dlobato/nixie12b_clock/README.md

# nixie12b_clock

This is just a simple project to build a clock using nixie displays. It's kind of a prototype to play with the nixies, although it's fully functional.
