dlobato/nixie12b_clock/hardware/nixie12b_clock.brd

## EAGLE design hardware/nixie12b_clock.brd (2015-03-19)

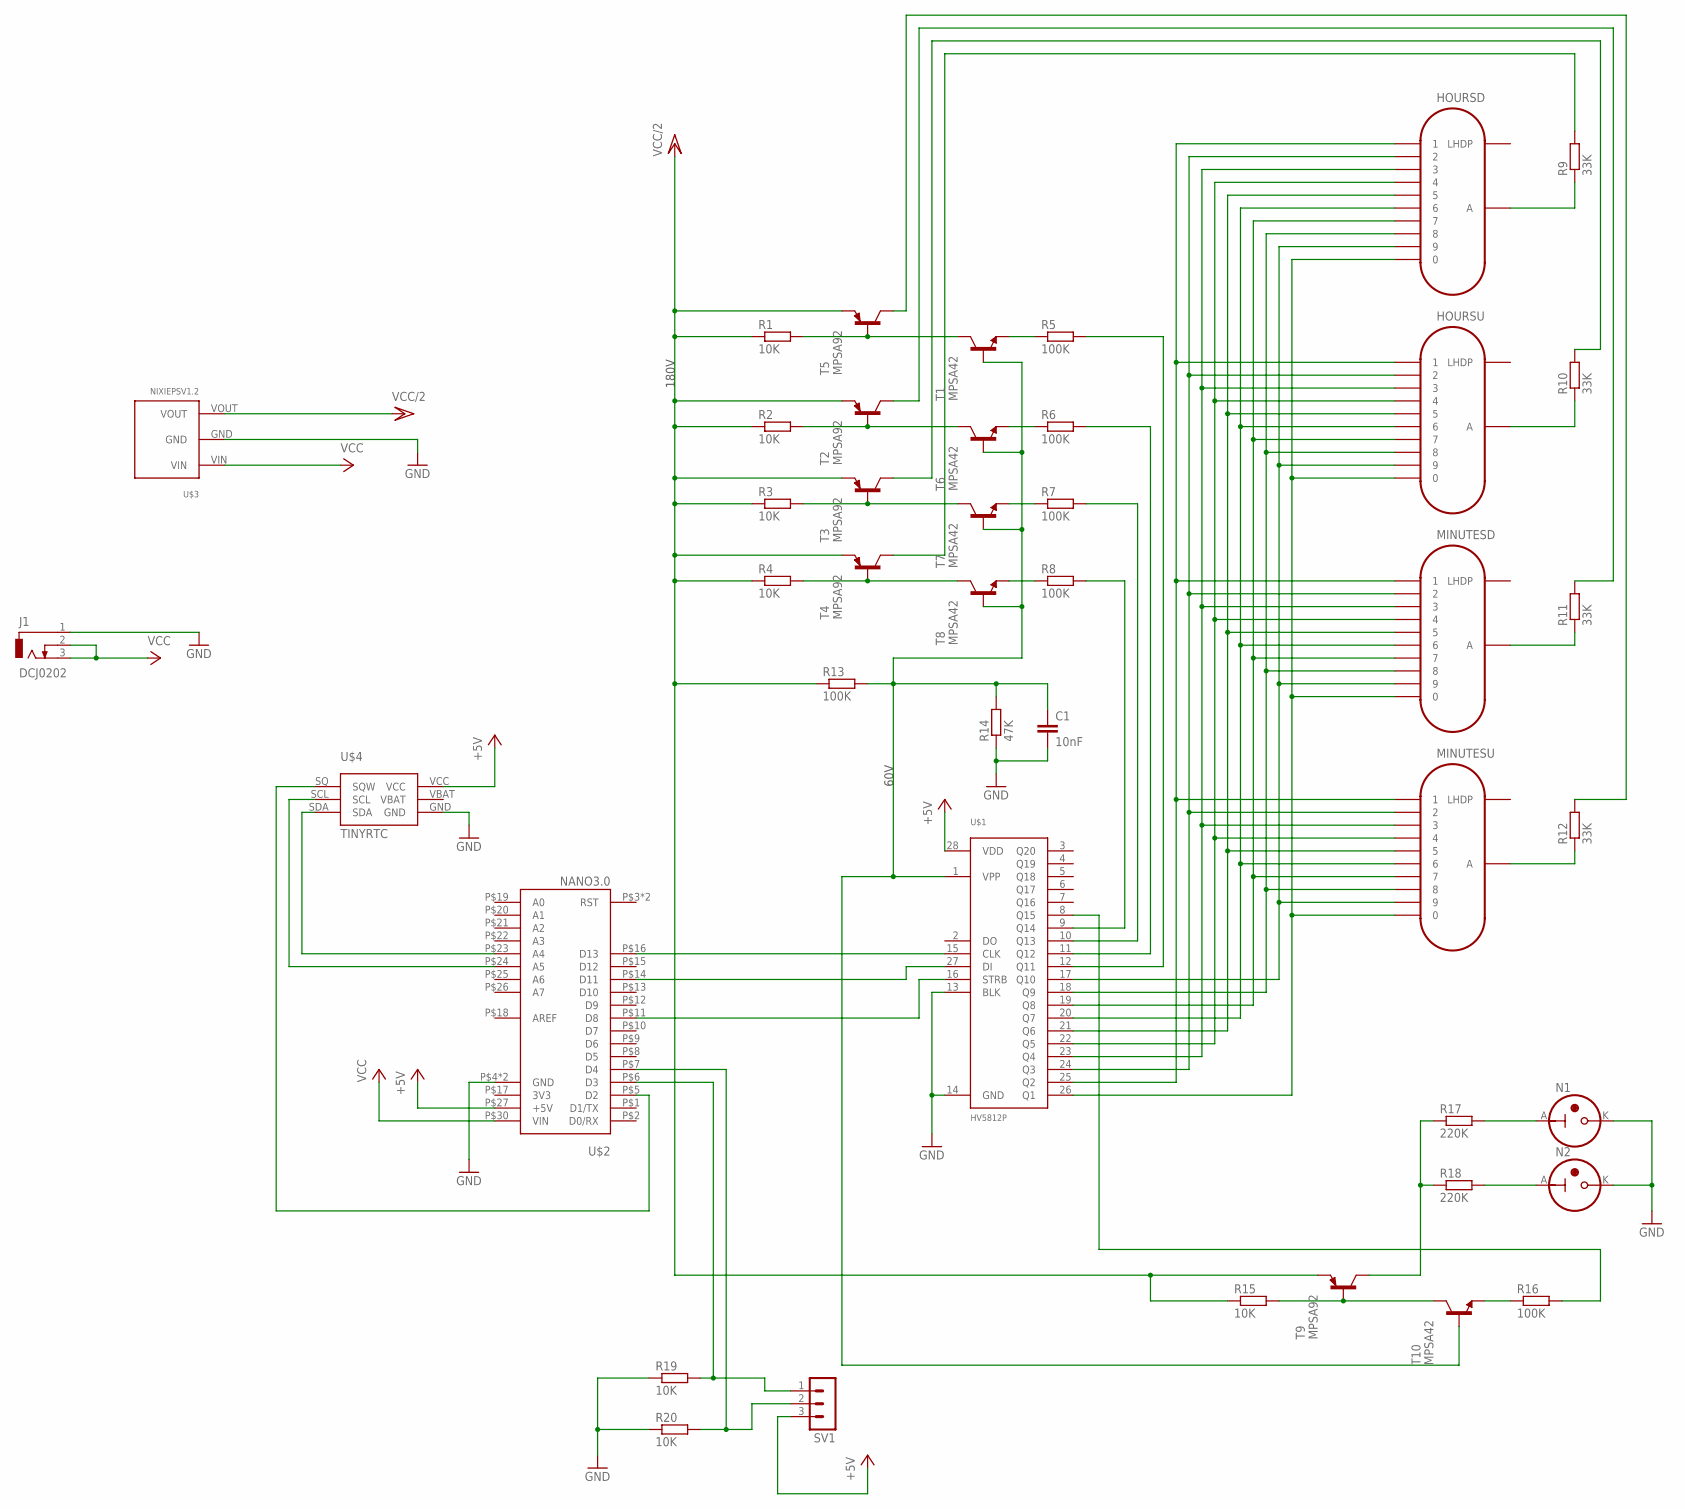
[picture p1: schematic nixie12b_clock.sch]

Parts:
C1: 10nF; C5B2.5
HOURSD: IN-12BP; IN-12-2
HOURSU: IN-12BP; IN-12-2
J1: DCJ0202
MINUTESD: IN-12BP; IN-12-2
MINUTESU: IN-12BP; IN-12-2
N1, N2: IN-3
R1, R2, R3, R4, R15, R19, R20: 10K; 0207/10
R5, R6, R7, R8, R13, R16: 100K; 0207/10
R9, R10, R11, R12: 33K; 0207/10
R14: 47K; 0207/10
R17, R18: 220K; 0207/10
SV1: MA03-1
T1, T6, T7, T8, T10: MPSA42; TO92-EBC
T2, T3, T4, T5, T9: MPSA92; TO92-EBC
U$1: HV5812P; 28-PDIP
U$2: NANO3.0; NANO3.0_HEADERS
U$3: NIXIEPSV1.2
U$4: TINYRTC

Connections:
3V3: U$2.P$17 (3V3)
+5V: SV1.3, U$1.28 (VDD), U$2.P$27 (+5V), U$4.VCC
GND: C1.2, J1.1, N1.K, N2.K, R14.1, R19.1, R20.1, U$1.13 (BLK), U$1.14 (GND), U$2.P$4 (GND), U$2.P$29 (GND), U$3.GND, U$4.GND
unnamed: HOURSD.1, HOURSU.1, MINUTESD.1, MINUTESU.1, U$1.25 (Q2)
unnamed: HOURSD.2, HOURSU.2, MINUTESD.2, MINUTESU.2, U$1.24 (Q3)
unnamed: HOURSD.3, HOURSU.3, MINUTESD.3, MINUTESU.3, U$1.23 (Q4)
unnamed: HOURSD.4, HOURSU.4, MINUTESD.4, MINUTESU.4, U$1.22 (Q5)
unnamed: HOURSD.5, HOURSU.5, MINUTESD.5, MINUTESU.5, U$1.21 (Q6)
unnamed: HOURSD.6, HOURSU.6, MINUTESD.6, MINUTESU.6, U$1.20 (Q7)
unnamed: HOURSD.7, HOURSU.7, MINUTESD.7, MINUTESU.7, U$1.19 (Q8)
unnamed: HOURSD.8, HOURSU.8, MINUTESD.8, MINUTESU.8, U$1.18 (Q9)
unnamed: HOURSD.9, HOURSU.9, MINUTESD.9, MINUTESU.9, U$1.17 (Q10)
unnamed: HOURSD.0, HOURSU.0, MINUTESD.0, MINUTESU.0, U$1.26 (Q1)
unnamed: R1.2, T1.C, T5.B
unnamed: R2.2, T2.B, T6.C
unnamed: R3.2, T3.B, T7.C
unnamed: R4.2, T4.B, T8.C
unnamed: R5.1, T1.E
unnamed: R6.1, T6.E
unnamed: R7.1, T7.E
unnamed: R8.1, T8.E
unnamed: C1.1, R13.2, R14.2, T1.B, T6.B, T7.B, T8.B, T10.B, U$1.1 (VPP)
unnamed: R5.2, U$1.12 (Q11)
unnamed: R6.2, U$1.11 (Q12)
unnamed: R7.2, U$1.10 (Q13)
unnamed: R8.2, U$1.9 (Q14)
unnamed: R9.2, T4.C
unnamed: HOURSD.A, R9.1
unnamed: R10.2, T3.C
unnamed: HOURSU.A, R10.1
unnamed: R11.2, T2.C
unnamed: MINUTESD.A, R11.1
unnamed: R12.2, T5.C
unnamed: MINUTESU.A, R12.1
unnamed: R15.2, T9.B, T10.C
unnamed: U$1.16 (STRB), U$2.P$11 (D8)
unnamed: U$1.27 (DI), U$2.P$14 (D11)
unnamed: U$1.15 (CLK), U$2.P$16 (D13)
unnamed: R19.2, SV1.1, U$2.P$6 (D3)
unnamed: R16.2, U$1.8 (Q15)
unnamed: R17.1, R18.1, T9.C
unnamed: R16.1, T10.E
unnamed: N1.A, R17.2
unnamed: N2.A, R18.2
unnamed: U$2.P$24 (A5), U$4.SCL
unnamed: U$2.P$23 (A4), U$4.SDA
unnamed: U$2.P$5 (D2), U$4.SQ (SQW)
unnamed: R20.2, SV1.2, U$2.P$7 (D4)
VBAT: U$4.VBAT
VCC: J1.2, J1.3, U$2.P$30 (VIN), U$3.VIN
VCC/2: R1.1, R2.1, R3.1, R4.1, R13.1, R15.1, T2.E, T3.E, T4.E, T5.E, T9.E, U$3.VOUT

Notes on the sheet:
60V
180V

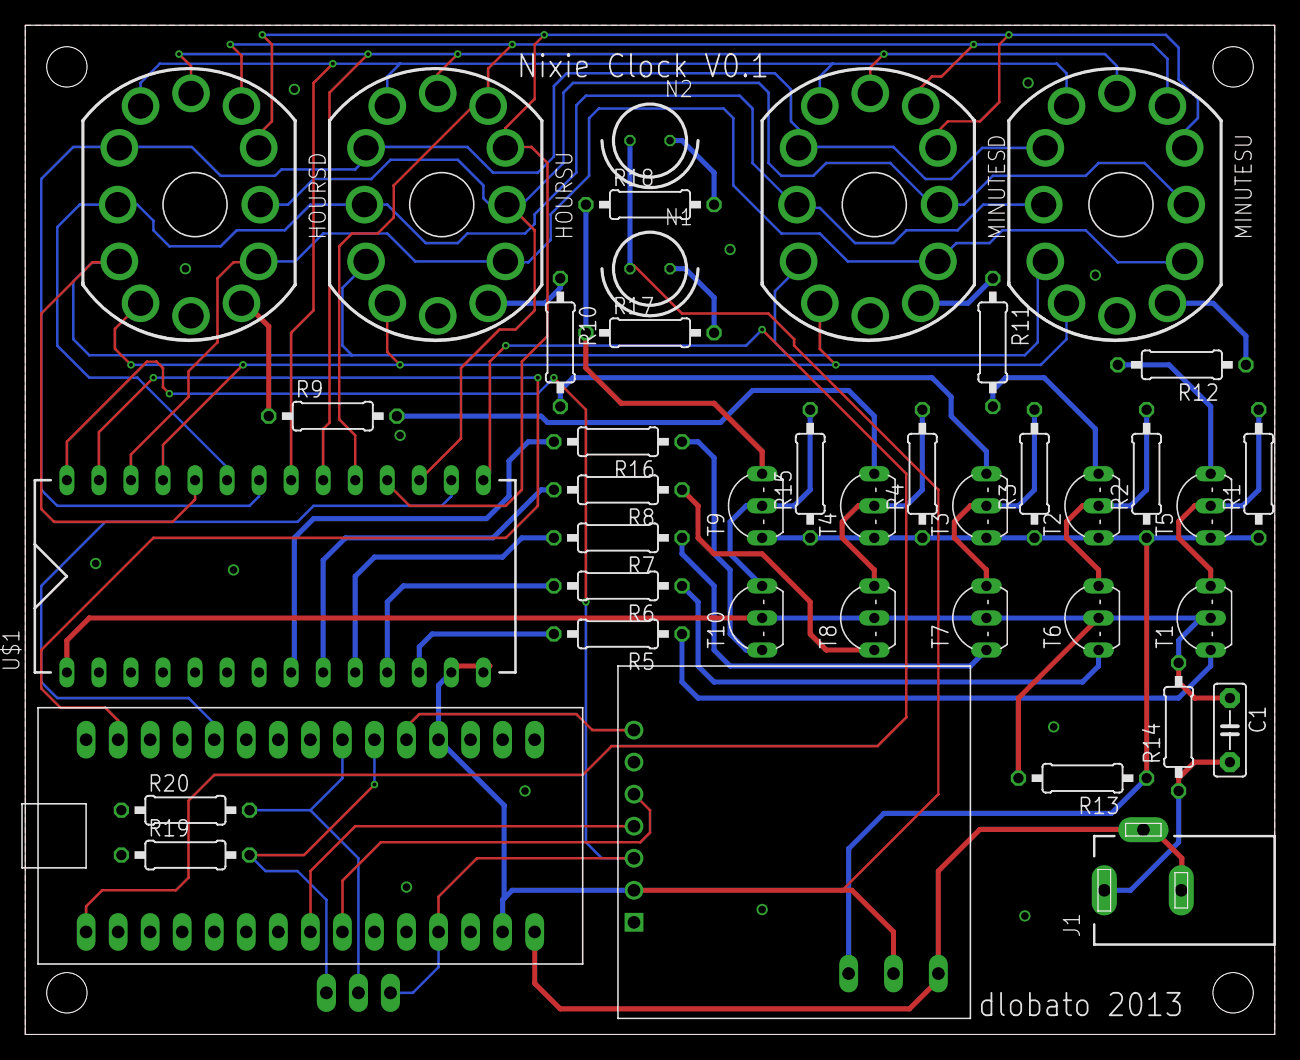
[picture p2: board nixie12b_clock.brd from above]

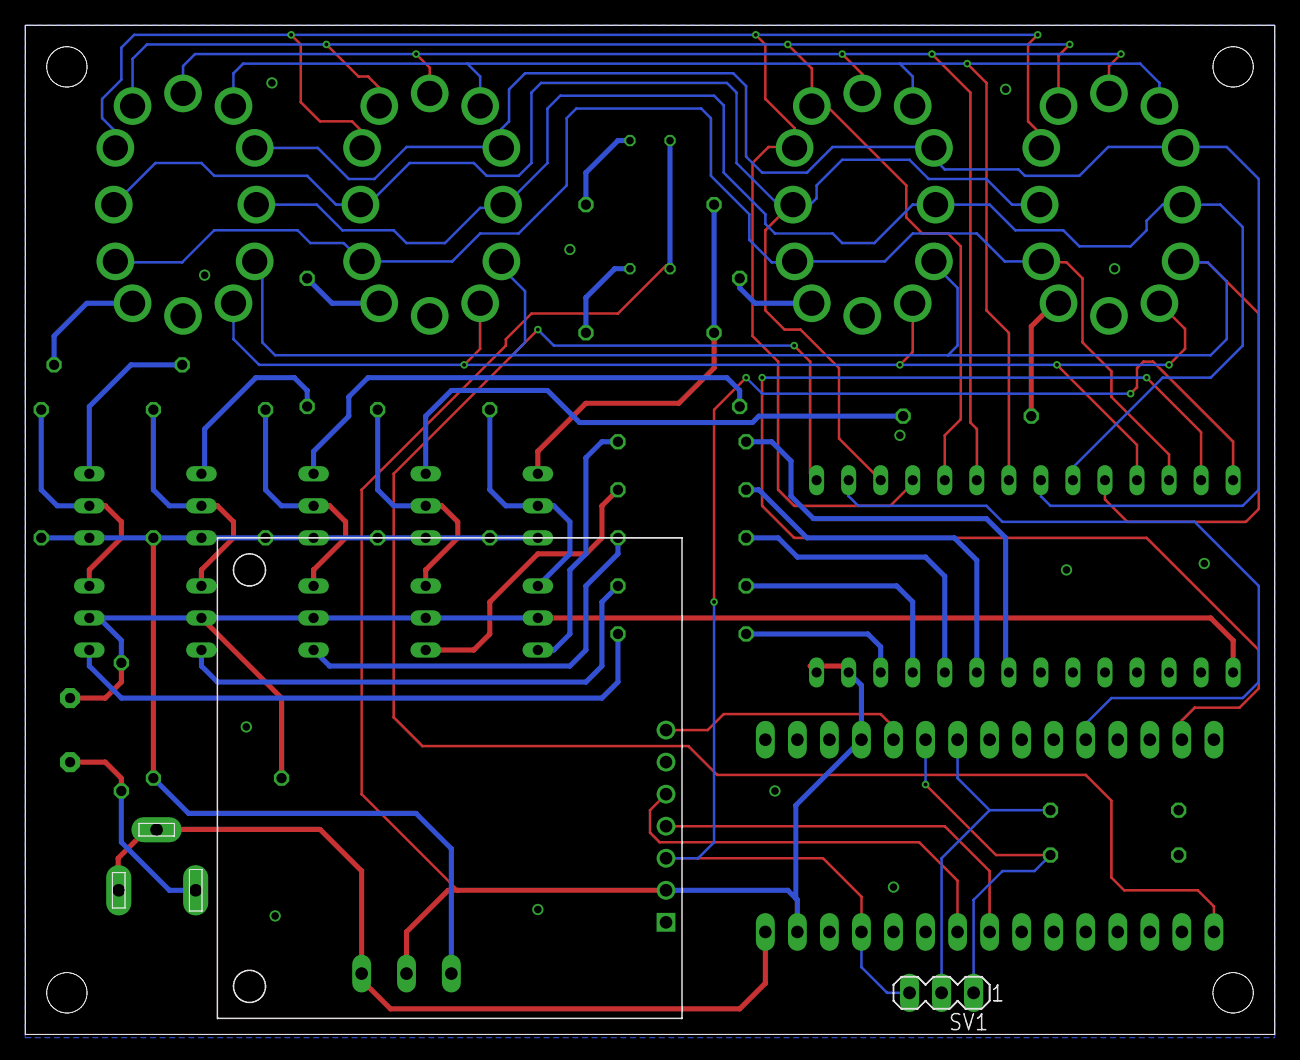
[picture p3: board nixie12b_clock.brd from below]

Board: 2 copper layers, 99.1 x 80.0 mm, 43 parts (2 on the bottom side), 49 nets.
