dlobato/nixie12b_clock/(commit log)

2015-03-19 add project files to repository
    [nixie12b_clock.brd, nixie12b_clock.sch]
2015-04-01 clean up timer1 code
2017-04-19 removed unnedded libs. undated time libs. added button controls to setup time.
